PowerFilm-Solar/REF-IN-BLE-NS_4/Wiki Photos/Getting Started/Programming_Wiring_Diagram.png

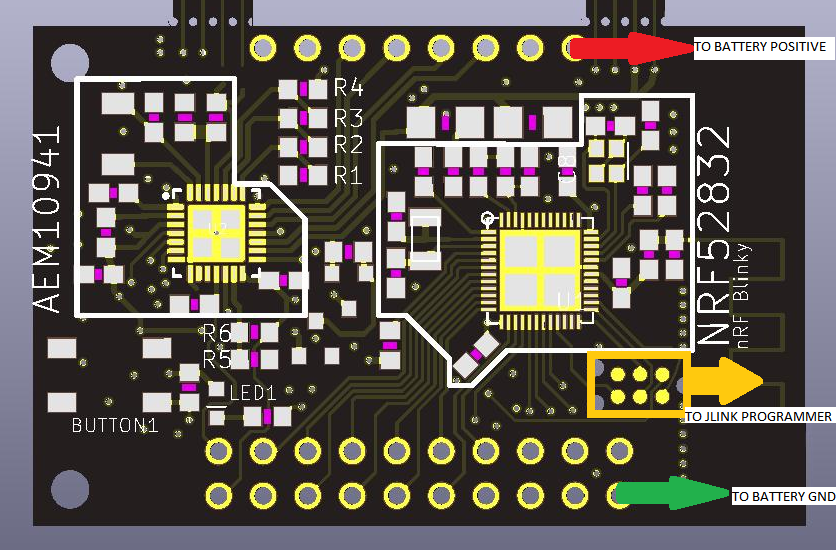
Wiki Photos/Getting Started/Programming_Wiring_Diagram.png
