PowerFilm-Solar/REF-IN-BLE-NS_4/Wiki Photos/Getting Started/Real_Programming_Wire_Diagram.jpg

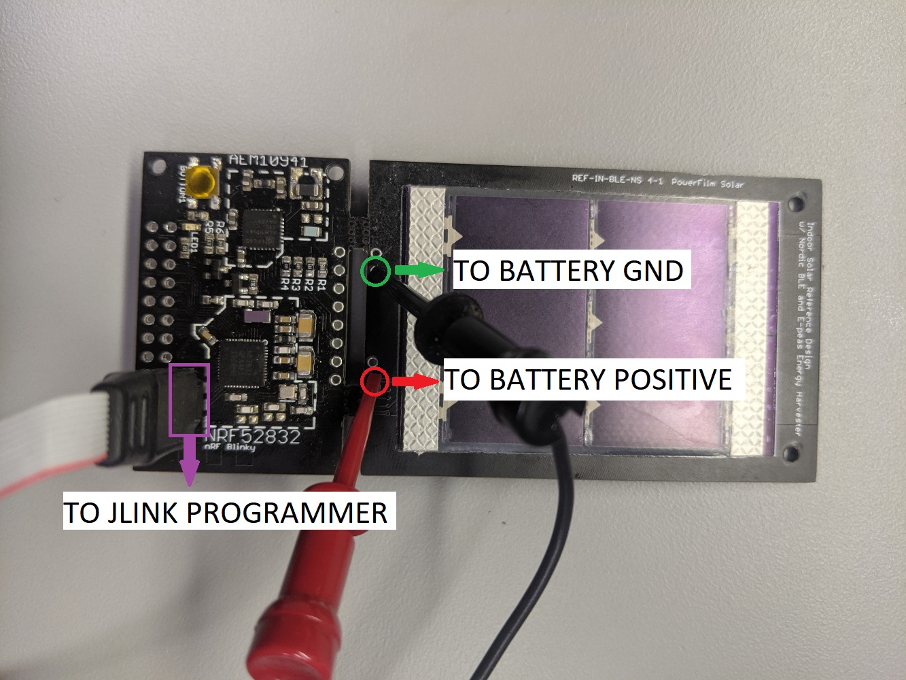
Wiki Photos/Getting Started/Real_Programming_Wire_Diagram.jpg
