PowerFilm-Solar/REF-IN-BLE-NS_4/README.md

# Thank you for your interest in PowerFilm's solar powered BLE reference Designs! Navigate to the Wiki tab to get started: https://github.com/PowerFilm-Solar/REF-IN-BLE-NS_4/wiki
