PowerFilm-Solar/REF-IN-BLE-NS_4/Boards/Mini/REF-BLE-MINI_Schematic.pdf

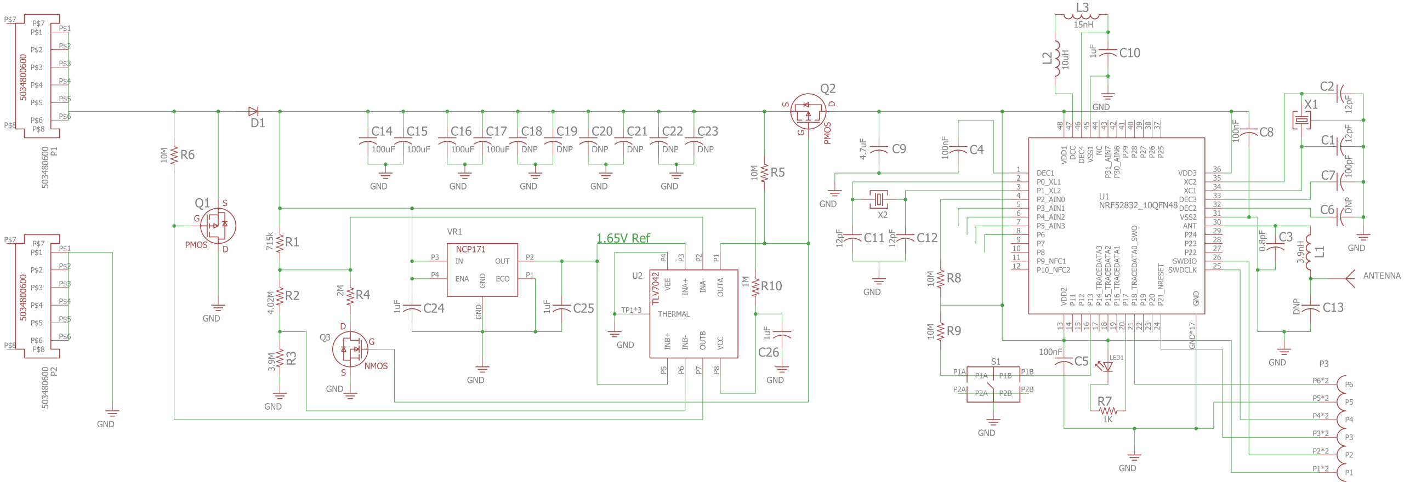
[picture p3: page 1]
