PowerFilm-Solar/REF-IN-BLE-NS_4/Boards/Flex/layout.pdf

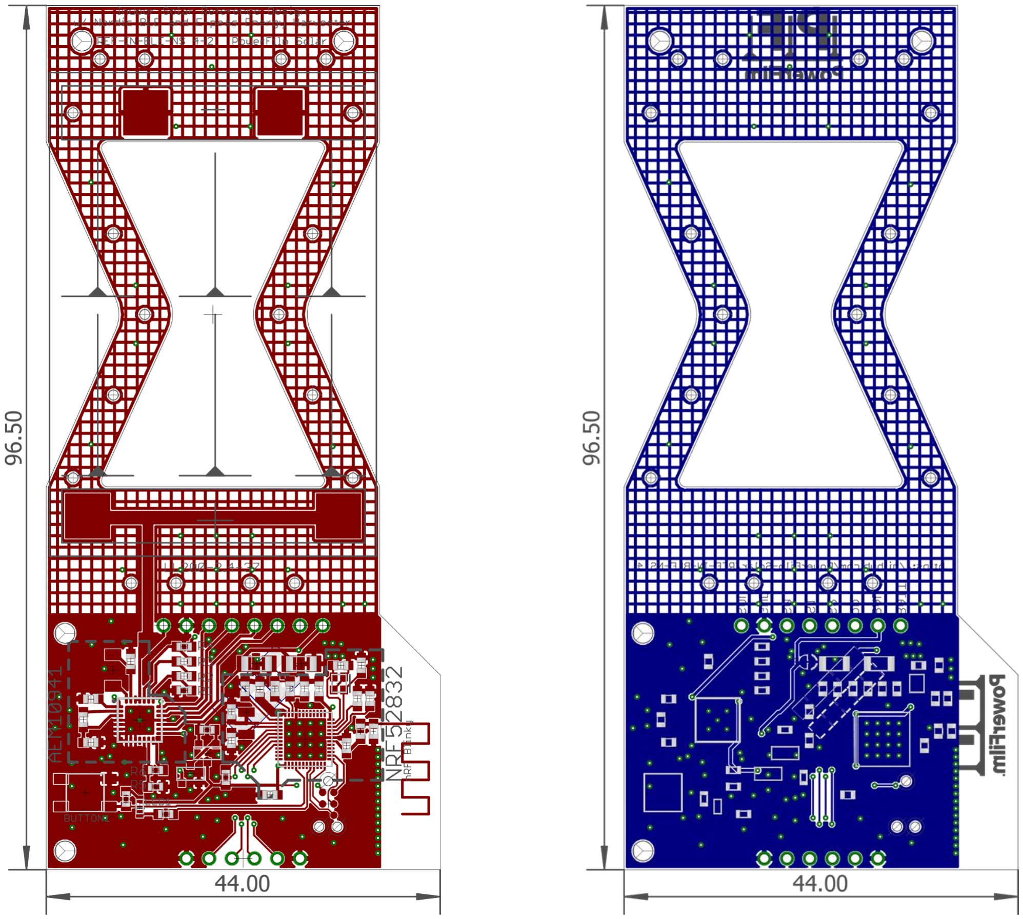
[picture p4: page 1]
