PowerFilm-Solar/REF-IN-BLE-NS_4/Boards/Rigid/layout.pdf

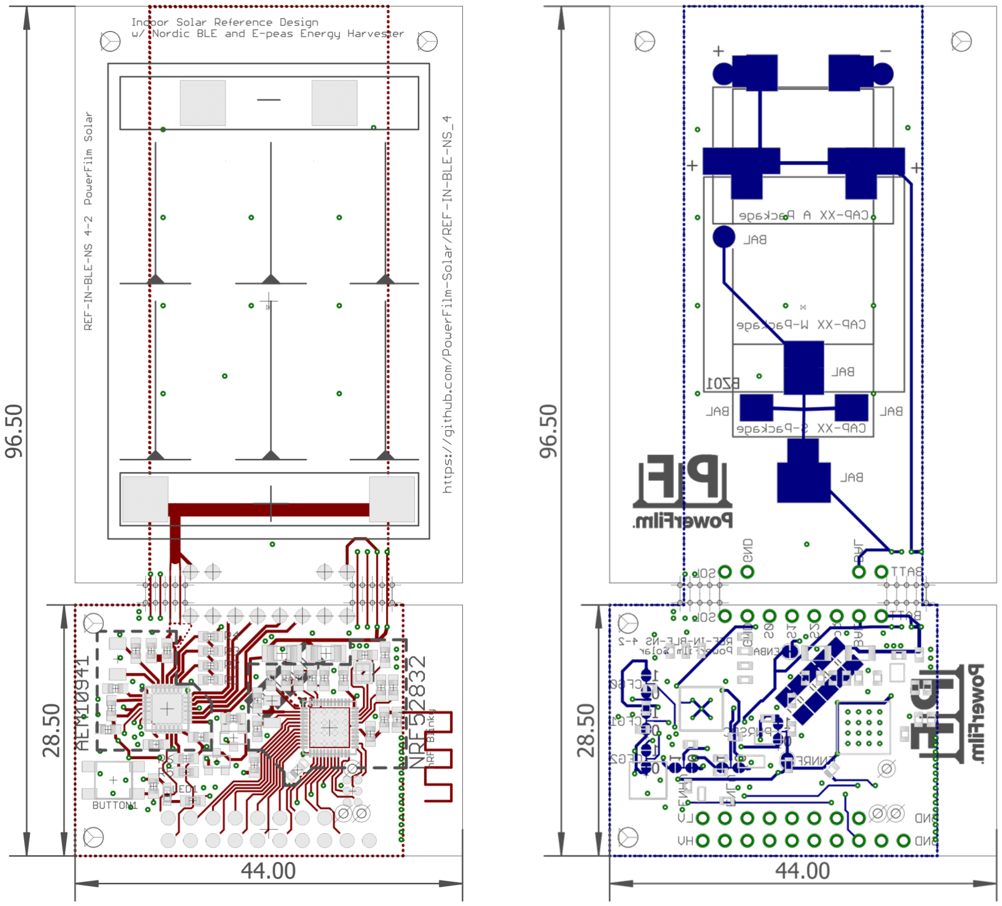
[picture p5: page 1]
