PowerFilm-Solar/REF-IN-BLE-NS_4/Wiki Photos/BLE_Reference_Designs.jpg

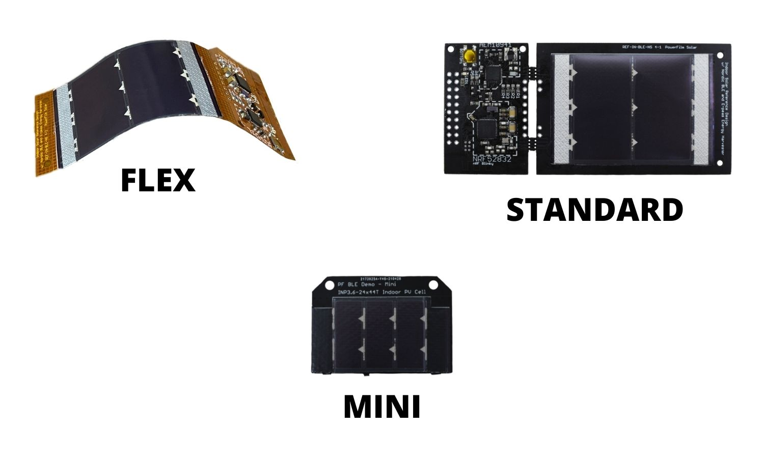
Wiki Photos/BLE_Reference_Designs.jpg
