PowerFilm-Solar/REF-IN-BLE-NS_4/Wiki Photos/Bootloader/Application Segger Loader.PNG

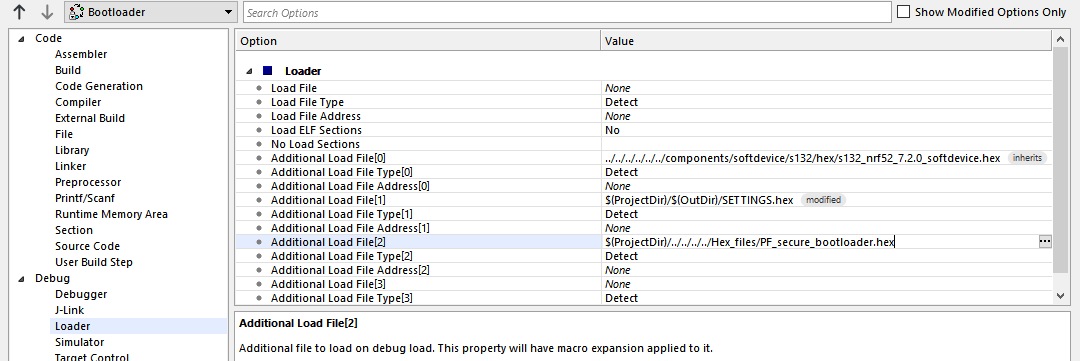
Wiki Photos/Bootloader/Application Segger Loader.PNG
