PowerFilm-Solar/REF-IN-BLE-NS_4/Wiki Photos/Bootloader/Bootloader Segger Post Link BL.PNG

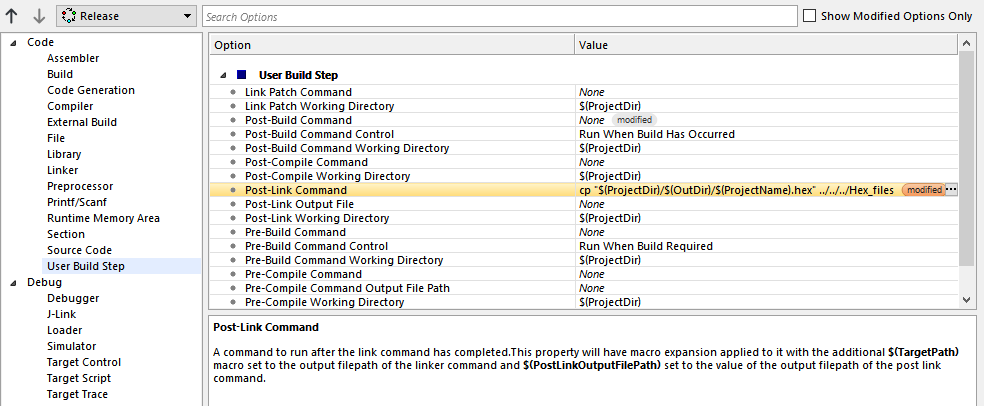
Wiki Photos/Bootloader/Bootloader Segger Post Link BL.PNG
