PowerFilm-Solar/REF-IN-BLE-NS_4/Wiki Photos/Bootloader/Files Needed.PNG

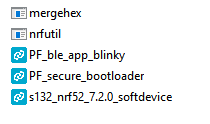
Wiki Photos/Bootloader/Files Needed.PNG
