PowerFilm-Solar/REF-IN-BLE-NS_4/Wiki Photos/Bootloader/Ready.png

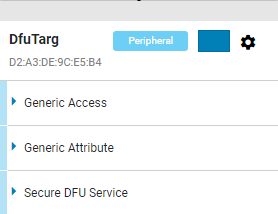
Wiki Photos/Bootloader/Ready.png
