PowerFilm-Solar/REF-IN-BLE-NS_4/Wiki Photos/Bootloader/Too early.png

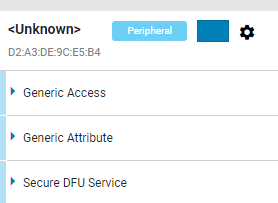
Wiki Photos/Bootloader/Too early.png
