PowerFilm-Solar/REF-IN-BLE-NS_4/Wiki Photos/Hardware Configuration/LDO_Bypass_Circuit_Block.PNG

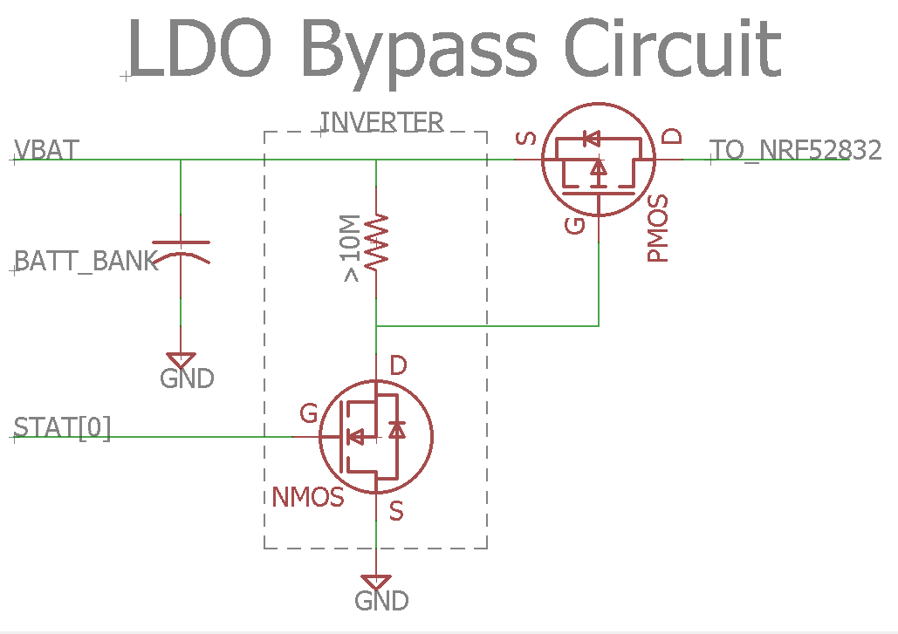
Wiki Photos/Hardware Configuration/LDO_Bypass_Circuit_Block.PNG
