PowerFilm-Solar/REF-IN-BLE-NS_4/Wiki Photos/Hardware Configuration/Recommended_Footprint.PNG

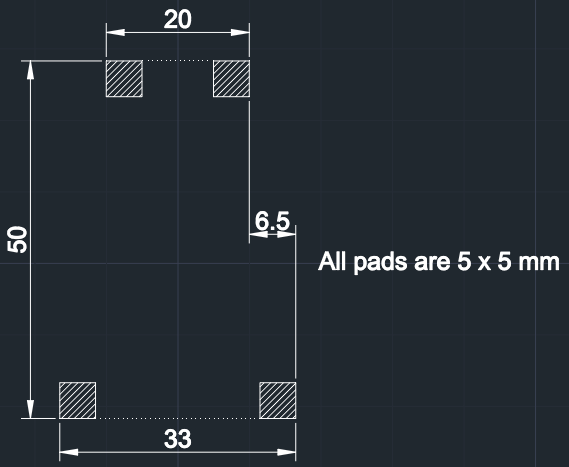
Wiki Photos/Hardware Configuration/Recommended_Footprint.PNG
