PowerFilm-Solar/REF-IN-BLE-NS_4/Wiki Photos/Power Saving Tips/PPK.PNG

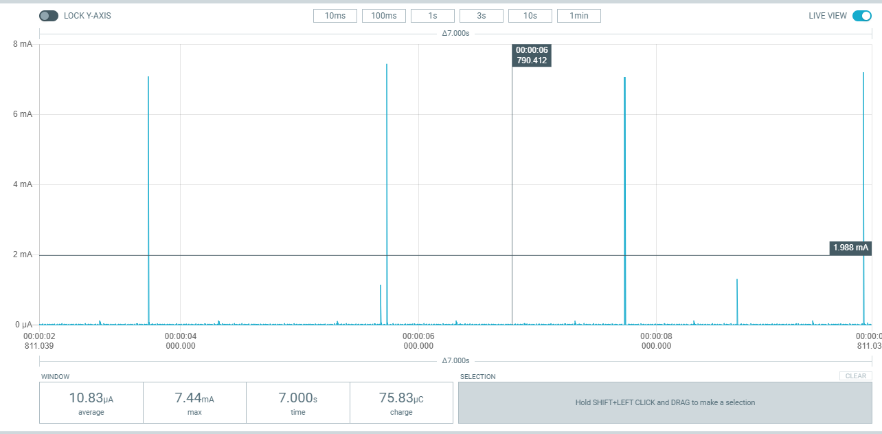
Wiki Photos/Power Saving Tips/PPK.PNG
