PowerFilm-Solar/REF-IN-BLE-NS_4/Boards/Mini/REF-BLE-MINI.xlsx

Sheet: Project BOM
Ref Des | Qty | Description | Size | Value | Percentage | Wattage | MFG Part #
R1 | 1 | Resistor | 0603 | 715k | 1% |  | RC0603FR-07715KL
R2 | 1 | Resistor | 0603 | 4.02M | 1% |  | RC0603FR-074M02L
R3 | 1 | Resistor | 0603 | 3.9M | 1% |  | CRCW06033M90FKEA‎
R4 | 1 | Resistor | 0603 | 2M | 1% |  | RC0603FR-072ML
R5,R6,R8,R9 | 4 | Resistor | 0603 | 10M | 1% |  | RC0603FR-0710ML
R7 | 1 | Resistor | 0603 | 1k | 1% |  | RMCF0603JJ1K00
R10 | 1 | Resistor | 0603 | 1M | 1% |  | RMCF0603FT1M00
C1,C2,C11,C12 | 4 | Capacitor | 0603 | 12pF | 2% | NP0 | GRM1885C1H120GA01D
C3 | 1 | Capacitor | 0603 | 0.8pF | 5% | NP0 | CBR06C808B5GAC
C4, C5, C8 | 3 | Capacitor | 0603 | 100nF | 10% | X5R | CL10B104KB8NNNC
C6 | 0 | Capacitor | 0603 | DNP
C7 | 1 | Capacitor | 0603 | 100pF | 5% | NP0 | CL10C101JB8NNNC
C9 | 1 | Capacitor | 0603 | 4.7uF | 5% | X5R | CL10A475KQ8NNWC
C10,C24,C25, C26 | 3 | Capacitor | 0603 | 1uF | 10% | X5R | CL10A105KP8NNNC
C13 | 0 | Capacitor | 0603 | DNP
C14,C15,C16,C17 | 4 | Capacitor | 1206 | 100uF |  |  | CL31A107MQHNNNE
C18,C19,C20,C21 ,C22,C23 | 0 | Capacitor | 1206 | DNP |  |  | DNP
L1 | 1 | Inductor | 0603 | 3.9nH | 5% |  | L-14C3N9SV4T
L2 | 1 | Inductor | 0603 | 10uH | 20% | 50mA | LBR2012T100M
L3 | 1 | Inductor | 0603 | 15nH | 10% |  | L-14C15NJV4T
D1 | 1 | Diode | SOD-523 | Schottky |  |  | BAT43WS-E3-08
LED1 | 1 | LED | 0603 |  |  |  | LTST-020KGKT
Q1,Q2 | 2 | Transistor | SOT-23 | P-Channel |  |  | BSS84,215
Q3 | 1 | Transistor | SOT-23 | N-Channel |  |  | NX138AKR
U1 | 1 | IC | 48-QFN |  |  |  | NRF52832-QFAA-R
U2 | 1 | IC | 8-WSON |  |  |  | TLV7042DSGR
VR1 | 1 | IC | 4-XDFN |  |  |  | NCP171AMX165160
X1 | 1 | Crystal | Nonstandard | 32MHz |  | 6pF | ECS-320-8-37B-CWY-TR
X2 | 1 | Crystal | Nonstandard | 32.768 kHz |  | 9pF | FC-135 32.7680KA-AC0
S1 | 1 | Switch | Nonstandard |  |  |  | EVQ-P7A01P
P1,P2 | 2 | Connector | Nonstandard |  |  |  | 5034800600

Sheet: Part Placement
Partlist
Exported | from REF-BLE-MINI.brd | at 9/1/2021 11:53 AM
EAGLE Ver | sion 7.7.0 Copyright ( | c) 1988-2016 CadSoft
Assembly | variant:
Part | Value | Package | Library | Position (mm) | Orientation
C1 | 12pF | C0603 | resistor | (28.41 23.49) | R0
C2 | 12pF | C0603 | resistor | (28.41 19.29) | R180
C3 | 0.8pF | C0603 | resistor | (34.8 20.8) | R180
C4 | 100nF | C0603 | resistor | (29.65 10.7) | R270
C5 | 100nF | C0603 | resistor | (40.29 13.01) | R0
C6 | DNP | C0603 | resistor | (32.6 23.2) | R90
C7 | 100pF | C0603 | resistor | (31.2 23.2) | R90
C8 | 100nF | C0603 | resistor | (28.4 17.9) | R180
C9 | 4.7uF | C0603 | resistor | (28.11 10.71) | R270
C10 | 1uF | C0603 | resistor | (26 19.2) | R90
C11 | 12pF | C0603 | resistor | (31.5 7.3) | R270
C12 | 12pF | C0603 | resistor | (34.3 7.3) | R270
C13 | DNP | C0603 | resistor | (37.3 23.7) | R0
C14 | 100uF | C1206 | resistor | (4 10.1) | R270
C15 | 100uF | C1206 | resistor | (6.3 10.1) | R270
C16 | 100uF | C1206 | resistor | (8.6 10.1) | R270
C17 | 100uF | C1206 | resistor | (10.9 10.1) | R270
C18 | DNP | C1206 | resistor | (13.2 10.1) | R270
C19 | DNP | C1206 | resistor | (15.5 10.1) | R270
C20 | DNP | C1206 | resistor | (17.8 10.1) | R270
C21 | DNP | C1206 | resistor | (20.1 10.1) | R270
C22 | DNP | C1206 | resistor | (22.4 10.1) | R270
C23 | DNP | C1206 | resistor | (24.7 10.1) | R270
C24 | 1uF | C0603 | resistor | (8.4 21.2) | R90
C25 | 1uF | C0603 | resistor | (5.1 18.6) | R180
C26 | 1uF | C0603 | resistor | (11 14.9) | R270
D1 | BAT43WS-E3-08 | SOD-323-VISHAY | 00_PF_Nordic | (6.9 13.7) | R180
L1 | 3.9nH | L0603 | 00_PF_Nordic | (35 23.4) | R270
L2 | 10uH | L0603 | 00_PF_Nordic | (28.4 14.6) | R0
L3 | 15nH | L0603 | 00_PF_Nordic | (28.4 15.9) | R180
LED1 | LTST-20KGKT | TST-20KGKT | 00_PF_Nordic | (34.1 1) | R180
P1 | 503480600 | 5034800600 | 00_PF_SMT | (5.4125 2) | R0
P2 | 503480600 | 5034800600 | 00_PF_SMT | (40.5875 2) | R0
Q1 | DMG2305U-13 | SOT-23-3-DIODESINC | 00_PF_Nordic | (4 16.2) | R180
Q2 | DMG2305U-13 | SOT-23-3-DIODESINC | 00_PF_Nordic | (16.1 15.7) | R270
Q3 | NX138AKR | SOT-23-3-RENESAS | 00_PF_Nordic | (15.5 21.4) | R90
R1 | 715k | R0603 | resistor | (10 21.2) | R270
R2 | 4.02M | R0603 | resistor | (11.4 21.2) | R90
R3 | 3.9M | R0603 | resistor | (12.8 21.2) | R270
R4 | 2M | R0603 | resistor | (14.2 18.4) | R0
R5 | 10M | R0603 | resistor | (13.5 15.7) | R90
R6 | 10M | R0603 | resistor | (6.5 16.4) | R90
R7 | 1K | R0603 | resistor | (36.96 3.82) | R90
R8 | 10M | R0603 | resistor | (36 7.3) | R270
R9 | 10M | R0603 | resistor | (31.85 4.25) | R180
R10 | 1M | R0603 | resistor | (9.5 14.9) | R90
S1 | EVQ-P7A01P | EVQ-P7A01P | 00_PF_Nordic | (28 1.4) | R0
U1 | NRF52832_10QFN48 | NRF52832_10 | 00_PF_Nordic | (34.5 16) | R90
U2 | TLV7042DSG | TLV7042DSG | 00_PF_Nordic | (10.4 17.8) | R180
VR1 | NCP171 | NCP171 | 00_PF_Nordic | (5.7 20.8) | R0
X1 | FA-128-32MHZMF10Z-AJ5 | FA-128-EPSON | 00_PF_Nordic | (28.51 21.39) | R90
X2 | FC-135-32.7680KA-AC0 | FC-135-32.7680KA-AC0 | 00_PF_Nordic | (32.9 9.9) | R180
