PowerFilm-Solar/REF-IN-BLE-NS_4/Wiki Photos/Bootloader/Application Segger Post Build.PNG

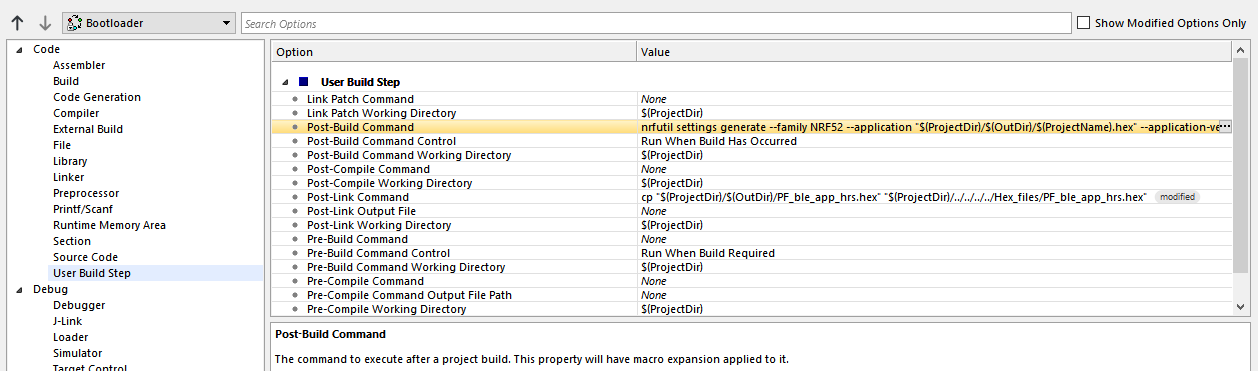
Wiki Photos/Bootloader/Application Segger Post Build.PNG
