PowerFilm-Solar/REF-IN-BLE-NS_4/Wiki Photos/Getting Started/Build_And_Run.PNG

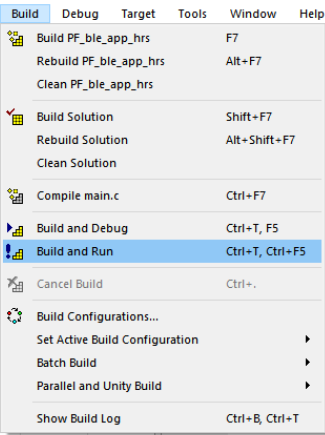
Wiki Photos/Getting Started/Build_And_Run.PNG
