PowerFilm-Solar/REF-IN-BLE-NS_4/Wiki Photos/Getting Started/Connection_To_HRM_Desktop_App.PNG

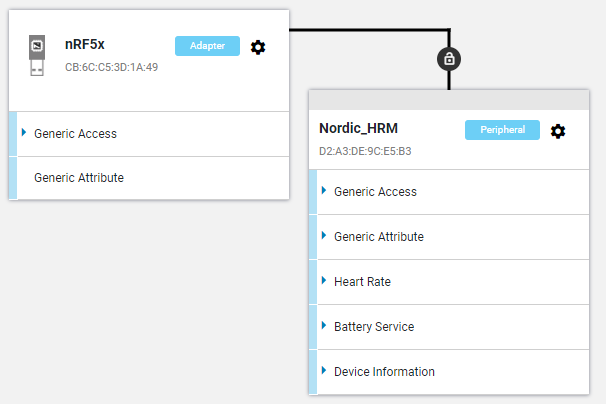
Wiki Photos/Getting Started/Connection_To_HRM_Desktop_App.PNG
