PowerFilm-Solar/REF-IN-BLE-NS_4/Wiki Photos/Getting Started/Ensure_These_Are_Selected.PNG

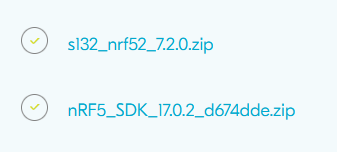
Wiki Photos/Getting Started/Ensure_These_Are_Selected.PNG
