PowerFilm-Solar/REF-IN-BLE-NS_4/Wiki Photos/Getting Started/Hex_Files_Folder.PNG

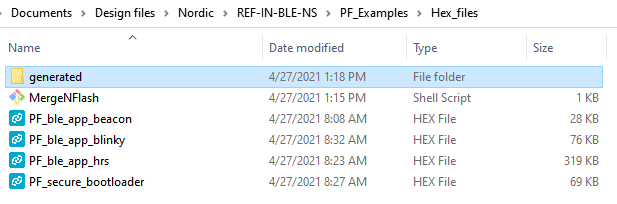
Wiki Photos/Getting Started/Hex_Files_Folder.PNG
