PowerFilm-Solar/REF-IN-BLE-NS_4/Wiki Photos/Getting Started/JLink_As_drive.PNG

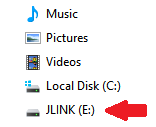
Wiki Photos/Getting Started/JLink_As_drive.PNG
