PowerFilm-Solar/REF-IN-BLE-NS_4/Wiki Photos/Getting Started/Preferred_Conn_Params.png

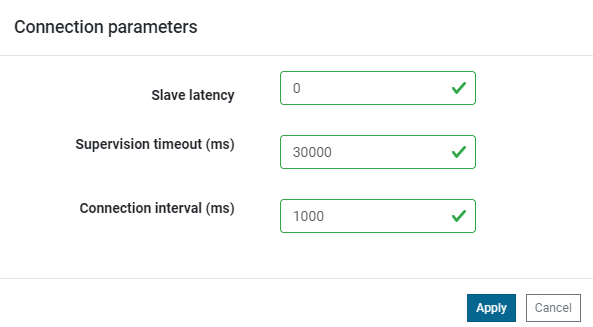
Wiki Photos/Getting Started/Preferred_Conn_Params.png
