PowerFilm-Solar/REF-IN-BLE-NS_4/Wiki Photos/Getting Started/SD_S132_Selected.PNG

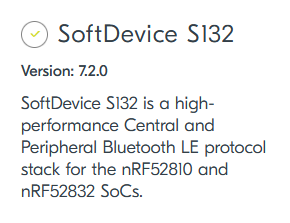
Wiki Photos/Getting Started/SD_S132_Selected.PNG
