PowerFilm-Solar/REF-IN-BLE-NS_4/Wiki Photos/Getting Started/SDK_17-0-2.PNG

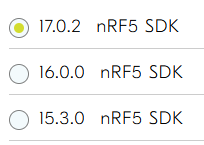
Wiki Photos/Getting Started/SDK_17-0-2.PNG
