PowerFilm-Solar/REF-IN-BLE-NS_4/Wiki Photos/Getting Started/Select_Conn_Params.png

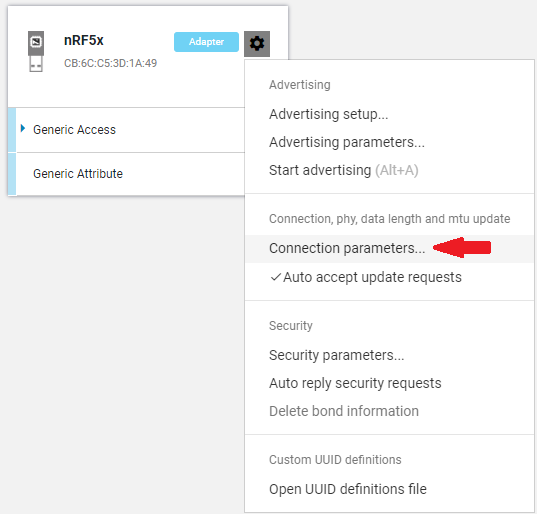
Wiki Photos/Getting Started/Select_Conn_Params.png
