PowerFilm-Solar/REF-IN-BLE-NS_4/(threads)

Thread 1 (2021-01-13):

REF-IN-BLE-NS 4-1 sam notes

samjonesPF, 2021-01-13:
- change solder bridge fonts to vector style -- make sure it doesn't effect alignment
- ENBAL needs to be mirrored
- change references to say revision 4-1
- change to 4 layer board with two internal ground planes. Go through and make sure any part that goes to ground has a ground via next to it.
- break negative panel contact up into two pads so all contacts are the same size
- add part labels to the button and switch
- add reference to "nRF Blinky" somewhere on the board since that is what we will load by default

Closed 2021-01-13.
