PowerFilm-Solar/REF-IN-BLE-NS_4/Boards/Rigid/schematic.pdf

CAP-XX Super-capacitors AVX Super-capacitors | 1206 Footprints

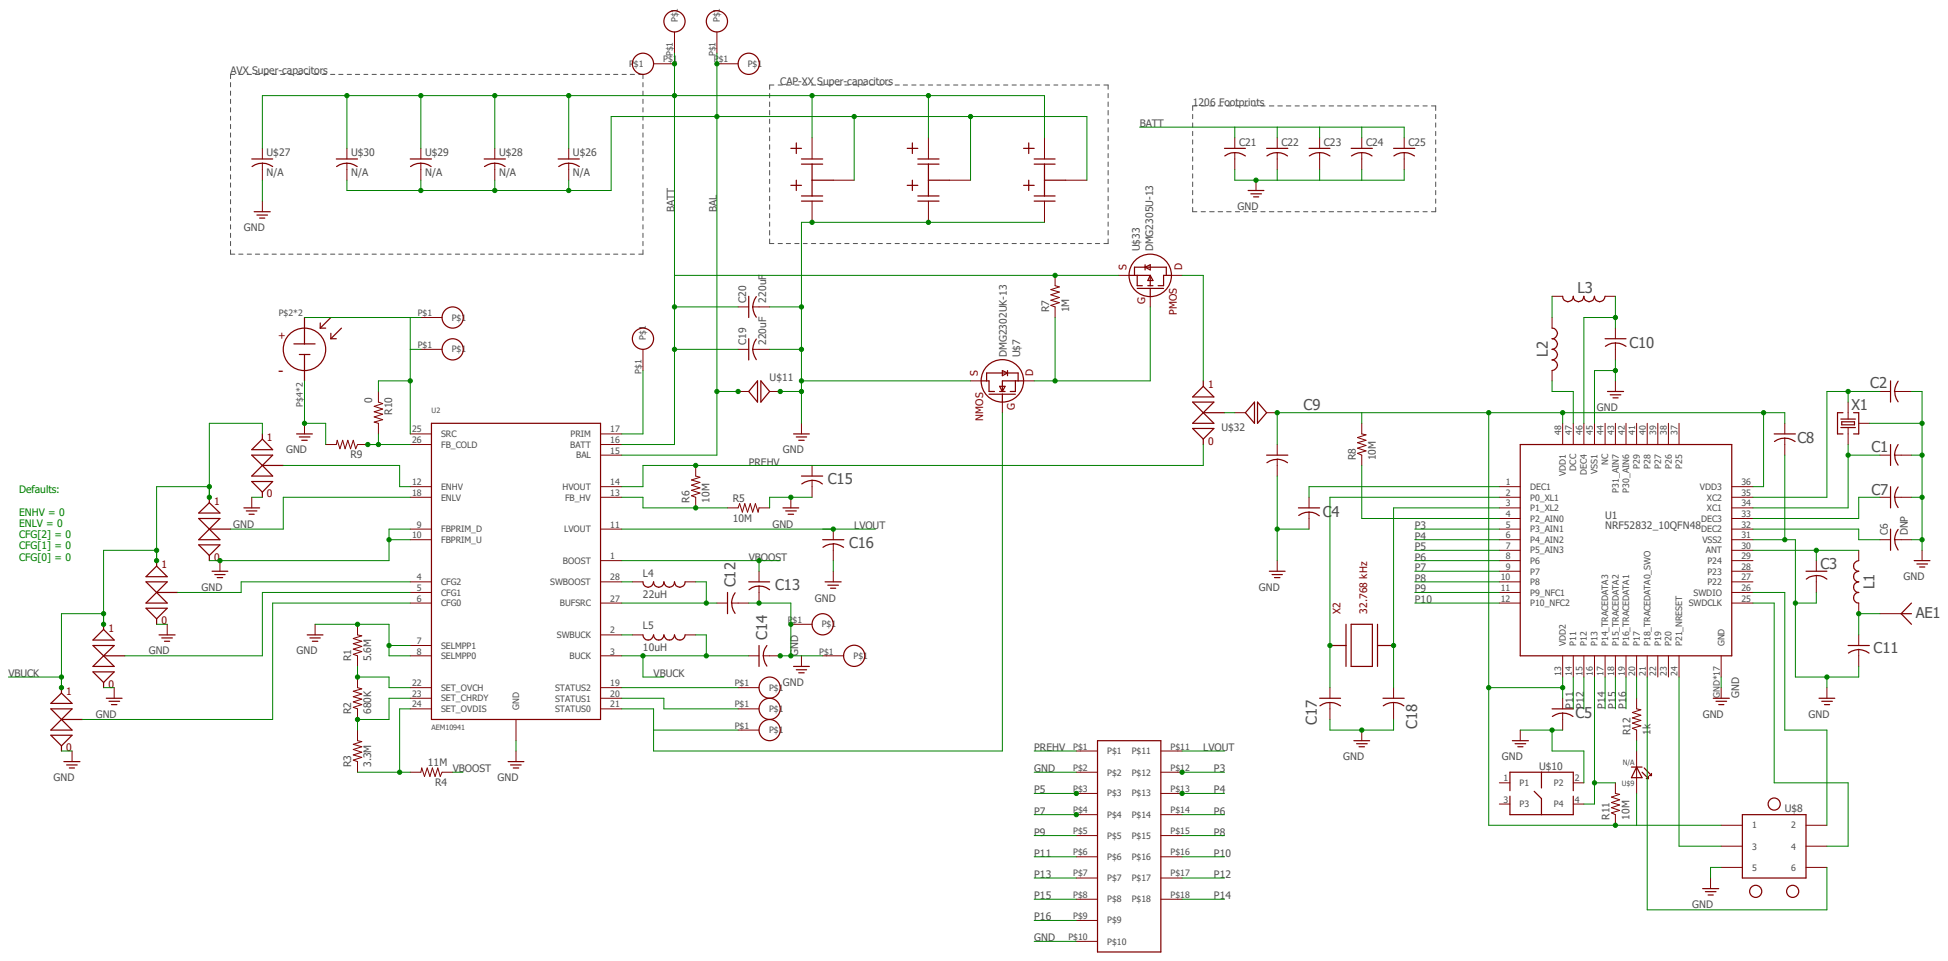
[picture p25: page 1]
