PowerFilm-Solar/REF-IN-BLE-NS_4/Boards/Flex/schematic.pdf

L3 L2 | L1

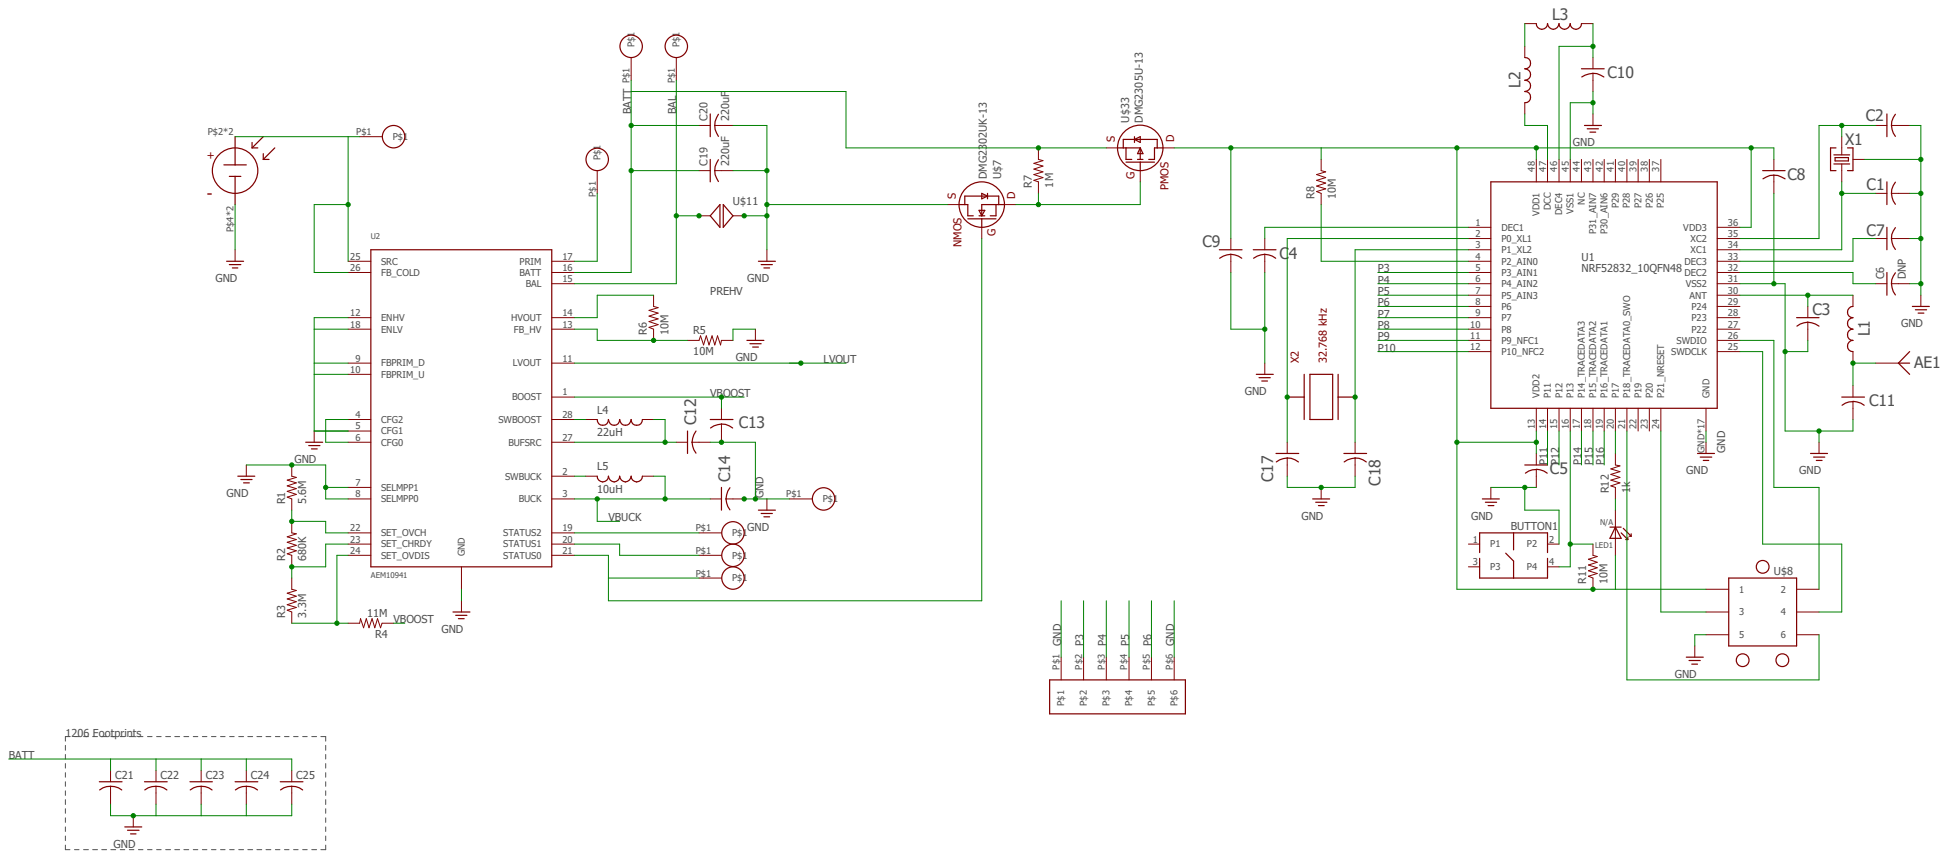
[picture p26: page 1]
