PowerFilm-Solar/REF-IN-BLE-NS_4/Boards/Mini/REF-BLE-MINI.brd

## EAGLE design Boards/Mini/REF-BLE-MINI.brd (2021-09-02)

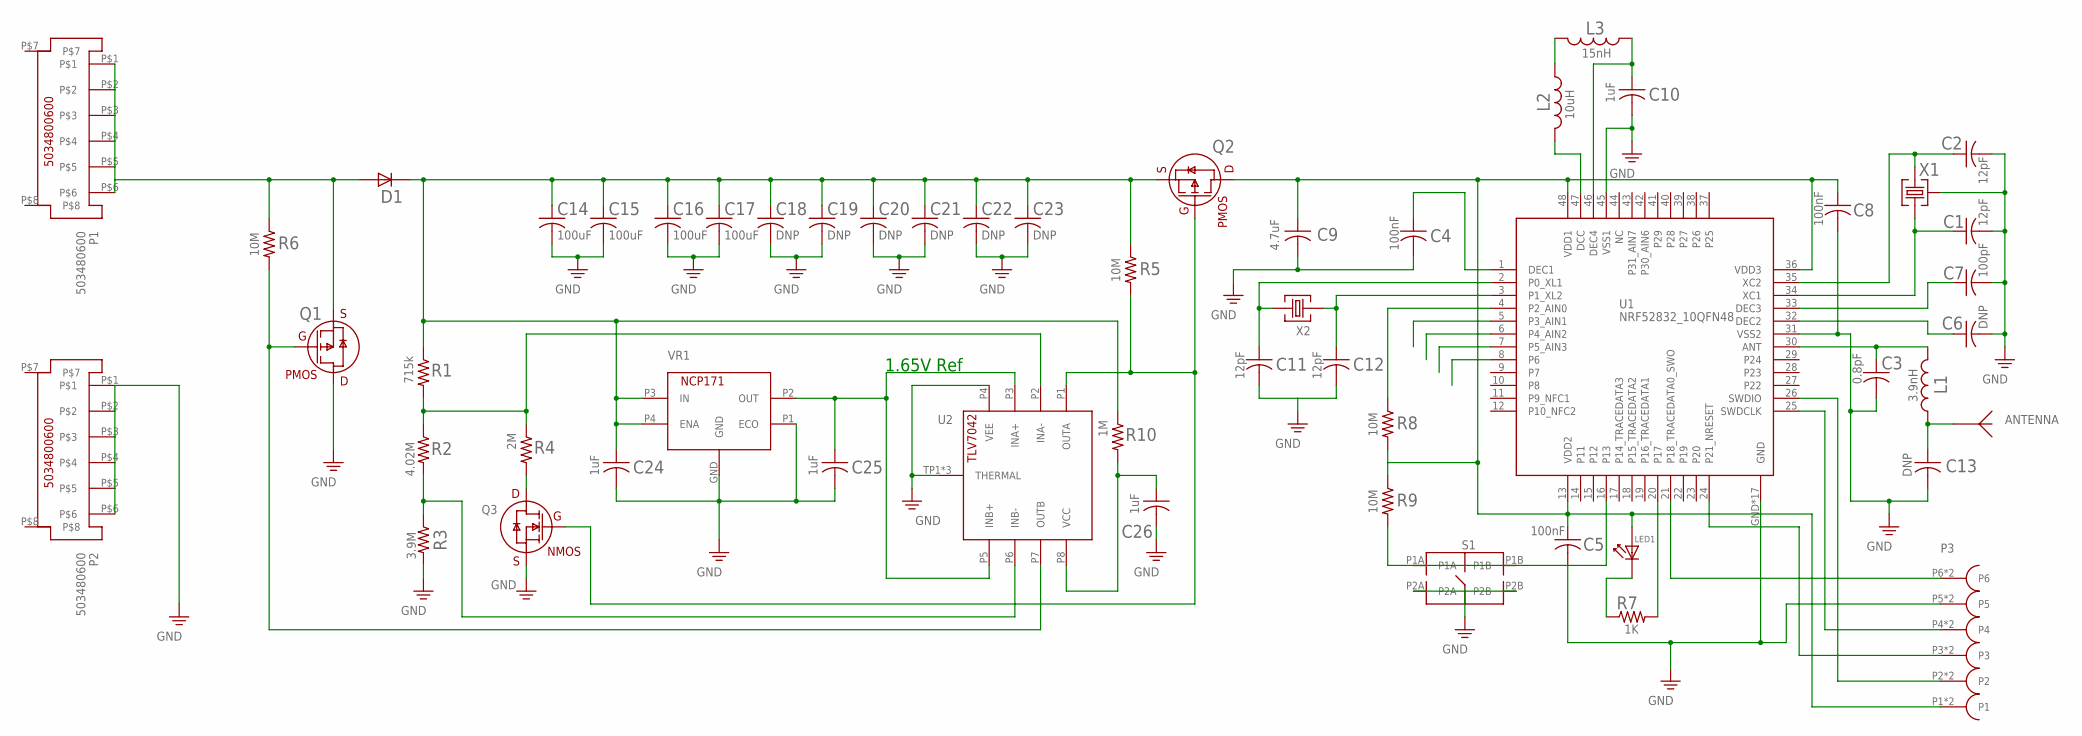
[picture p27: schematic REF-BLE-MINI.sch, sheet 1]

Parts:
ANTENNA: BLE-ANTENNA-NORDIC-2
C1, C2, C11, C12: 12pF; C0603
C3: 0.8pF; C0603
C4, C5, C8: 100nF; C0603
C6, C13: DNP; C0603
C7: 100pF; C0603
C9: 4.7uF; C0603
C10, C24, C25, C26: 1uF; C0603
C14, C15, C16, C17: 100uF; C1206
C18, C19, C20, C21, C22, C23: DNP; C1206
D1: BAT43WS-E3-08; SOD-323-VISHAY
L1: 3.9nH; L0603
L2: 10uH; L0603
L3: 15nH; L0603
LED1: LTST-20KGKT; TST-20KGKT
P1, P2: 503480600; 5034800600
P3: EC-06-CTX
Q1, Q2: DMG2305U-13; SOT-23-3-DIODESINC
Q3: NX138AKR; SOT-23-3-RENESAS
R1: 715k; R0603
R2: 4.02M; R0603
R3: 3.9M; R0603
R4: 2M; R0603
R5, R6, R8, R9: 10M; R0603
R7: 1K; R0603
R10: 1M; R0603
S1: EVQ-P7A01P
U1: NRF52832_10QFN48; NRF52832_10
U2: TLV7042DSG
VR1: NCP171
X1: FA-128-32MHZMF10Z-AJ5; FA-128-EPSON
X2: FC-135-32.7680KA-AC0

Connections:
GND: C1.2, C2.2, C3.2, C4.2, C5.2, C6.2, C7.2, C8.2, C9.2, C10.2, C11.2, C12.2, C13.2, C14.2, C15.2, C16.2, C17.2, C18.2, C19.2, C20.2, C21.2, C22.2, C23.2, C24.2, C25.2, P2.P$1, P2.P$2, P2.P$3, P2.P$4, P2.P$5, P2.P$6, P3.P5, P3.P11 (P5), Q1.3 (D), Q3.2 (S), R3.2, S1.P2A, S1.P2B, U1.31 (VSS2), U1.45 (VSS1), U1.GND, U1.P$2 (GND), U1.P$3 (GND), U1.P$4 (GND), U1.P$5 (GND), U1.P$6 (GND), U1.P$7 (GND), U1.P$8 (GND), U1.P$9 (GND), U1.P$10 (GND), U1.P$11 (GND), U1.P$12 (GND), U1.P$13 (GND), U1.P$14 (GND), U1.P$15 (GND), U1.P$16 (GND), U1.P$17 (GND), U2.P4 (VEE), U2.TP1 (THERMAL), U2.TP2 (THERMAL), U2.TP3 (THERMAL), VR1.GND, VR1.P1 (ECO), X1.P2 (P3), X1.P4 (P3)
unnamed: L2.2, U1.47 (DCC)
unnamed: L2.1, L3.2
unnamed: C10.1, L3.1, U1.46 (DEC4)
unnamed: C12.1, U1.3 (P1_XL2), X2.P$1 (1)
unnamed: C4.1, U1.1 (DEC1)
unnamed: C2.1, U1.35 (XC2), X1.P1 (2)
unnamed: C1.1, U1.34 (XC1), X1.P3 (1)
unnamed: C3.1, L1.2, U1.30 (ANT)
unnamed: ANTENNA.P$1, ANTENNA.P$2, C13.1, L1.1
unnamed: C7.1, U1.33 (DEC3)
unnamed: C6.1, U1.32 (DEC2)
unnamed: D1.P2, P1.P$1, P1.P$2, P1.P$3, P1.P$4, P1.P$5, P1.P$6, Q1.2 (S), R6.1
unnamed: C11.1, U1.2 (P0_XL1), X2.P$2 (2)
unnamed: C14.1, C15.1, C16.1, C17.1, C18.1, C19.1, C20.1, C21.1, C22.1, C23.1, C24.1, D1.P1, Q2.2 (S), R1.1, R5.1, R10.1, VR1.P3 (IN), VR1.P4 (ENA)
unnamed: R1.2, R2.1, R4.1, U2.P2 (INA-)
unnamed: Q2.1 (G), Q3.1 (G), R5.2, U2.P1 (OUTA)
unnamed: LED1.C, R7.1
unnamed: R2.2, R3.1, U2.P6 (INB-)
unnamed: R7.2, U1.20 (P17)
unnamed: C25.1, U2.P3 (INA+), U2.P5 (INB+), VR1.P2 (OUT)
unnamed: P3.P4, P3.P10 (P4), U1.25 (SWDCLK)
unnamed: P3.P3, P3.P9 (P3), U1.24 (P21_NRESET)
unnamed: Q1.1 (G), R6.2, U2.P7 (OUTB)
unnamed: R9.2, S1.P1A, S1.P1B, U1.16 (P13)
unnamed: P3.P6, P3.P12 (P6), U1.21 (P18_TRACEDATA0_SWO)
unnamed: P3.P2, P3.P8 (P2), U1.26 (SWDIO)
unnamed: R8.1, U1.4 (P2_AIN0)
unnamed: C5.1, C8.1, C9.1, LED1.A, P3.P1, P3.P7 (P1), Q2.3 (D), R8.2, R9.1, U1.13 (VDD2), U1.36 (VDD3), U1.48 (VDD1)
unnamed: Q3.3 (D), R4.2
unnamed: C26.1, R10.2, U2.P8 (VCC)
PE: C26.2

Notes on the sheet:
1.65V Ref

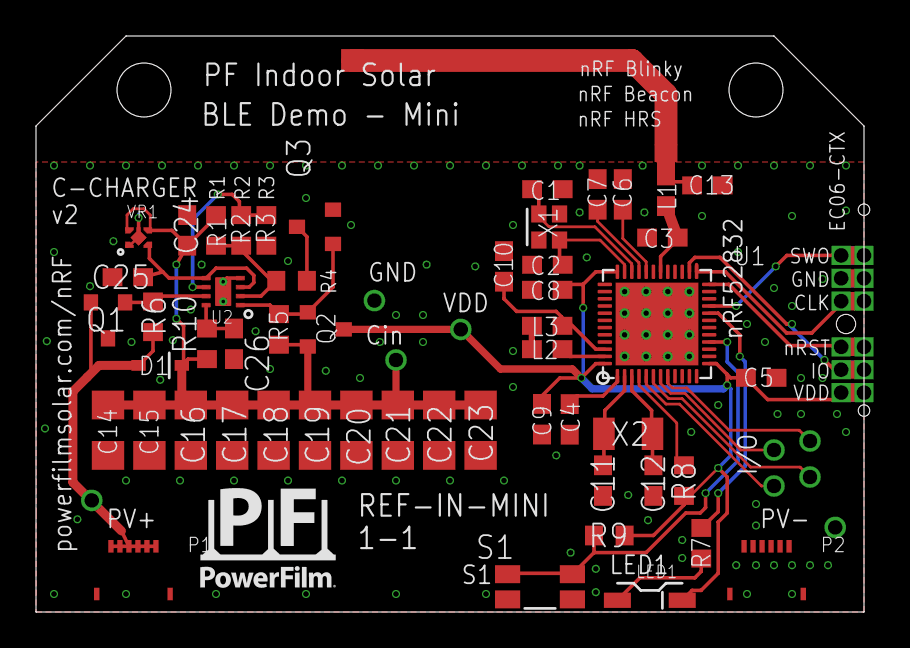
[picture p28: board REF-BLE-MINI.brd from above]

Board: 2 copper layers, 46.0 x 32.0 mm, 54 parts (0 on the bottom side), 31 nets.
