PowerFilm-Solar/REF-IN-BLE-NS_4/Boards/Rigid/REF-IN-BLE-NS 4-2 Rigid.brd

## EAGLE design Boards/Rigid/REF-IN-BLE-NS 4-2 Rigid.brd (2021-08-06)

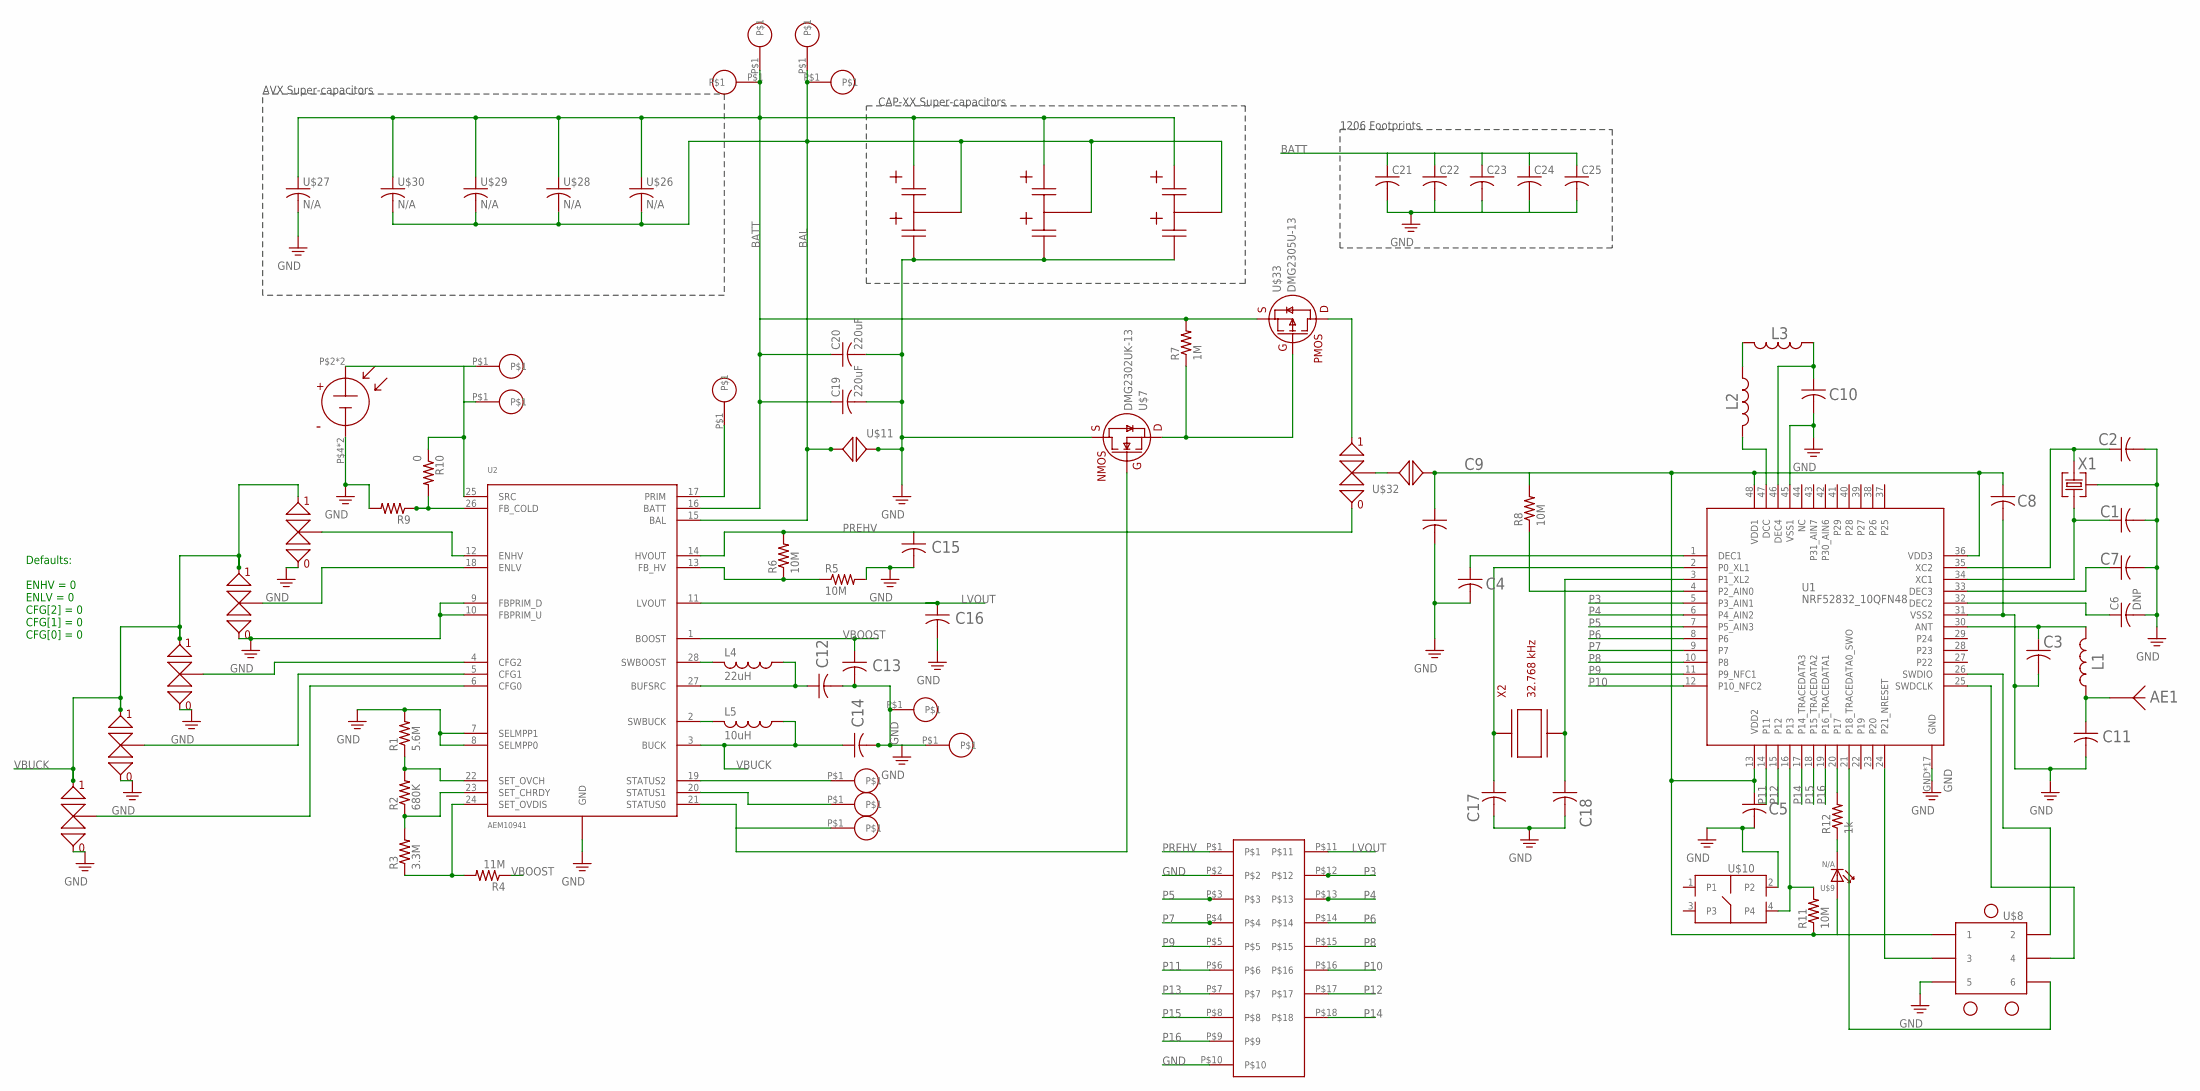
[picture p29: schematic REF-IN-BLE-NS 4-2 Rigid.sch]

Parts:
AE1: 2.4GHZ_ANTENNAFLIPPED; BLE_ANTENNA_NORDIC_FLIPPED
C1, C2: 12pF; C0603
C3: 0.8pF; C0603
C4, C5, C8: 100nF; C0603
C6, C11: DNP; C0603
C7: 100pF; C0603
C9: 4.7uF; C0603
C10: 1uF; C0603
C12, C14, C15, C16: 10uF; C0603
C13: 22uF; C0603
C17, C18: 12p; C0603
C19, C20: 220uF; C1206
C21, C22, C23, C24, C25: C-USC1206; C1206
L1: 3.9nH; L0603
L2, L5: 10uH; L0603
L3: 15nH; L0603
L4: 22uH; L1206
R1: 5.6M; R0603
R2: 680K; R0603
R3: 3.3M; R0603
R4: 11M; R0603
R5, R6, R8, R11: 10M; R0603
R7: 1M; R0603
R9: R-US_R0603; R0603
R10: 0; R0603
R12: 1k; R0603
U1: NRF52832_10QFN48; NRF52832_10
U2: AEM10941; QFN28_5X5_05PITCH
U$2, U$3, U$4, U$5, U$6: N/A; DOUBLE_SOLDER_BRIDGE_0_CLOSED
U$7: DMG2302UK-13; SOT-23-3-DIODESINC
U$8: N/A; TC2030-IDC
U$9: N/A; APT1608LZGCK
U$10: MJTP1140; MJTP1140A
U$11, U$32: SOLDER_BRIGDECLOSED; SOLDER_BRIDGE_CLOSED
U$12, U$13, U$14, U$15, U$17, U$18, U$19, U$35, U$36, U$39, U$40, U$41: N/A; 1MM_PAD
U$16: SOLAR_CELL_LL200-2.4-37; SOLAR_CELL_37X54MM
U$20: 18PIN_CONN; 20PIN_CONN
U$23: N/A; CAP-XX_A-TYPE
U$24: N/A; CAP-XX_S-TYPE
U$25: N/A; CAP-XX_W-TYPE
U$26: N/A; BZ01_L-TYPE
U$27: N/A; BZ059_N-TYPE
U$28: N/A; BZ01_S-TYPE
U$29: N/A; BZ05_S-TYPE
U$30: N/A; BZ09_S-TYPE
U$31: DOUBLE_SOLDER_BRIDGE1_CLOSED; DOUBLE_SOLDER_BRIDGE_1_CLOSED
U$33: DMG2305U-13; SOT-23-3-DIODESINC
X1: 32 MHz; FA-128-EPSON
X2: 32.768 kHz; FC-135

Connections:
BAL: U2.15 (BAL), U$11.P$1 (P1), U$19.P$1, U$23.P$1 (BAL), U$24.P$1 (BAL), U$25.P$1 (BAL), U$26.P$3 (2), U$26.P$4 (2), U$28.P$3 (2), U$29.P$3 (2), U$30.P$3 (2), U$41.P$1
BATT: C19.1, C20.1, C21.1, C22.1, C23.1, C24.1, C25.1, R7.2, U2.16 (BATT), U$18.P$1, U$23.P$2 (+), U$24.P$2 (+), U$25.P$2 (+), U$26.P$1 (1), U$26.P$2 (1), U$27.P$1 (1), U$28.P$1 (1), U$28.P$2 (1), U$29.P$1 (1), U$29.P$2 (1), U$30.P$1 (1), U$30.P$2 (1), U$33.2 (S), U$40.P$1
GND: C1.2, C2.2, C3.2, C4.2, C5.2, C6.2, C7.2, C8.2, C9.2, C10.2, C11.2, C12.2, C13.2, C14.2, C15.2, C16.2, C17.2, C18.2, C19.2, C20.2, C21.2, C22.2, C23.2, C24.2, C25.2, R1.2, R5.2, R9.2, U1.31 (VSS2), U1.45 (VSS1), U1.GND, U1.P$2 (GND), U1.P$3 (GND), U1.P$4 (GND), U1.P$5 (GND), U1.P$6 (GND), U1.P$7 (GND), U1.P$8 (GND), U1.P$9 (GND), U1.P$10 (GND), U1.P$11 (GND), U1.P$12 (GND), U1.P$13 (GND), U1.P$14 (GND), U1.P$15 (GND), U1.P$16 (GND), U1.P$17 (GND), U2.7 (SELMPP1), U2.8 (SELMPP0), U2.9 (FBPRIM_D), U2.10 (FBPRIM_U), U2.GND, U2.GND1 (GND), U2.GND2 (GND), U2.GND3 (GND), U2.GND4 (GND), U2.GND5 (GND), U$2.IN0, U$3.IN0, U$4.IN0, U$5.IN0, U$6.IN0, U$7.2 (S), U$8.P5 (5), U$10.2, U$11.P$2 (P2), U$16.P$4 (GND), U$16.P$5 (GND), U$17.P$1, U$20.P$2, U$20.P$10, U$23.P$3 (-), U$24.P$3 (-), U$25.P$3 (-), U$27.P$2 (2), U$35.P$1, X1.P2 (P3), X1.P4 (P3)
HVOUT: C5.1, C8.1, C9.1, R8.2, R11.1, U1.13 (VDD2), U1.36 (VDD3), U1.48 (VDD1), U$8.P1 (1), U$9.A, U$32.P$1 (P1)
LVOUT: C16.1, U2.11 (LVOUT), U$20.P$11
unnamed: L2.2, U1.47 (DCC)
unnamed: L2.1, L3.2
unnamed: C10.1, L3.1, U1.46 (DEC4)
unnamed: C4.1, U1.1 (DEC1)
unnamed: C2.1, U1.35 (XC2), X1.P1 (2)
unnamed: C1.1, U1.34 (XC1), X1.P3 (1)
unnamed: C3.1, L1.2, U1.30 (ANT)
unnamed: AE1.P$1, C11.1, L1.1
unnamed: C7.1, U1.33 (DEC3)
unnamed: C6.1, U1.32 (DEC2)
unnamed: L4.P$2 (2), U2.28 (SWBOOST)
unnamed: C12.1, L4.P$1 (1), U2.27 (BUFSRC)
unnamed: R1.1, R2.2, U2.22 (SET_OVCH)
unnamed: L5.2, U2.2 (SWBUCK)
unnamed: R2.1, R3.2, U2.23 (SET_CHRDY)
unnamed: R11.2, U1.16 (P13), U$10.4
unnamed: R3.1, R4.2, U2.24 (SET_OVDIS)
unnamed: U2.4 (CFG2), U$4.OUT
unnamed: U2.18 (ENLV), U$3.OUT
unnamed: U1.25 (SWDCLK), U$8.P4 (4)
unnamed: U1.24 (P21_NRESET), U$8.P3 (3)
unnamed: U2.12 (ENHV), U$2.OUT
unnamed: U1.26 (SWDIO), U$8.P2 (2)
unnamed: U1.21 (P18_TRACEDATA0_SWO), U$8.P6 (6)
unnamed: U2.5 (CFG1), U$5.OUT
unnamed: U2.6 (CFG0), U$6.OUT
unnamed: R5.1, R6.1, U2.13 (FB_HV)
unnamed: R10.1, U2.25 (SRC), U$16.P$2 (VOUT), U$16.P$3 (VOUT), U$36.P$1, U$39.P$1
unnamed: R12.1, U$9.C
unnamed: R12.2, U1.20 (P17)
unnamed: R9.1, R10.2, U2.26 (FB_COLD)
unnamed: C17.1, U1.2 (P0_XL1), X2.P$1
unnamed: C18.1, U1.3 (P1_XL2), X2.P$2
unnamed: R8.1, U1.4 (P2_AIN0)
unnamed: U$31.OUT, U$32.P$2 (P2)
unnamed: U$31.IN1, U$33.3 (D)
unnamed: R7.1, U$7.3 (D), U$33.1 (G)
P3: U1.5 (P3_AIN1), U$20.P$12
P4: U1.6 (P4_AIN2), U$20.P$13
P5: U1.7 (P5_AIN3), U$20.P$3
P6: U1.8 (P6), U$20.P$14
P7: U1.9 (P7), U$20.P$4
P8: U1.10 (P8), U$20.P$15
P9: U1.11 (P9_NFC1), U$20.P$5
P10: U1.12 (P10_NFC2), U$20.P$16
P11: U1.14 (P11), U$20.P$6
P12: U1.15 (P12), U$20.P$17
P13: U$20.P$7
P14: U1.17 (P14_TRACEDATA3), U$20.P$18
P15: U1.18 (P15_TRACEDATA2), U$20.P$8
P16: U1.19 (P16_TRACEDATA1), U$20.P$9
PREHV: C15.1, R6.2, U2.14 (HVOUT), U$20.P$1, U$31.IN0
PRIM: U2.17 (PRIM), U$12.P$1
STATUS0: U2.21 (STATUS0), U$7.1 (G), U$15.P$1
STATUS1: U2.20 (STATUS1), U$14.P$1
STATUS2: U2.19 (STATUS2), U$13.P$1
VBOOST: C13.1, R4.1, U2.1 (BOOST)
VBUCK: C14.1, L5.1, U2.3 (BUCK), U$2.IN1, U$3.IN1, U$4.IN1, U$5.IN1, U$6.IN1

Notes on the sheet:
Defaults: ENHV = 0 ENLV = 0 CFG[2] = 0 CFG[1] = 0 CFG[0] = 0
CAP-XX Super-capacitors
AVX Super-capacitors
1206 Footprints

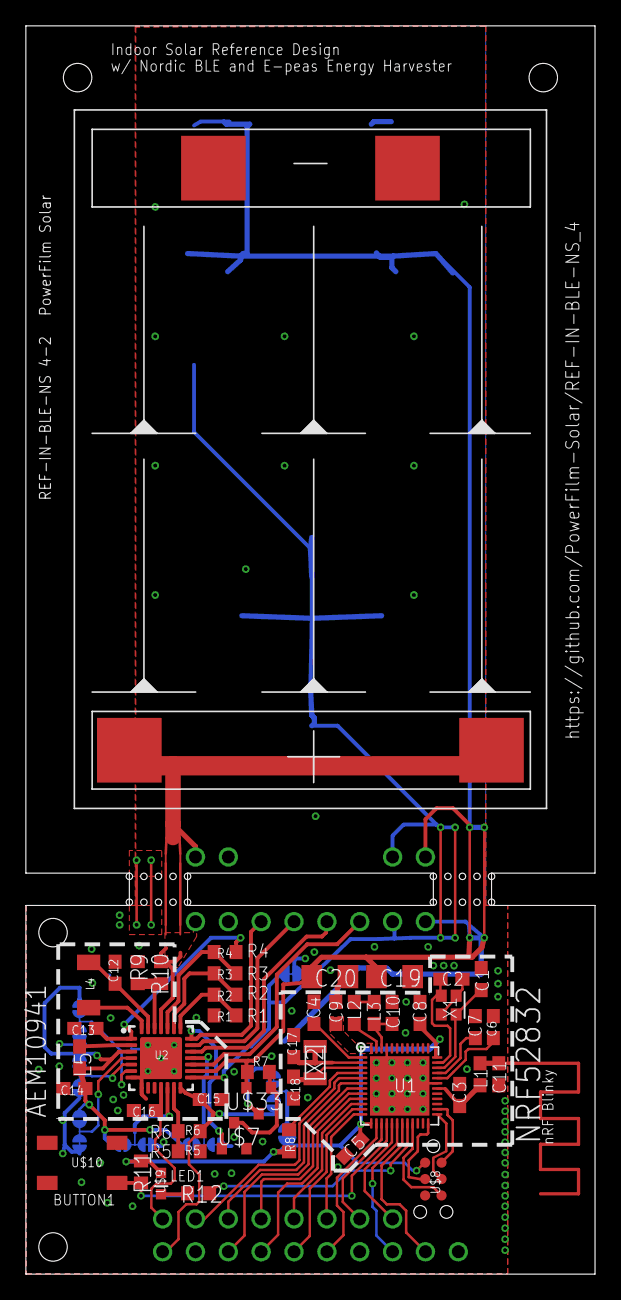
[picture p30: board REF-IN-BLE-NS 4-2 Rigid.brd from above]

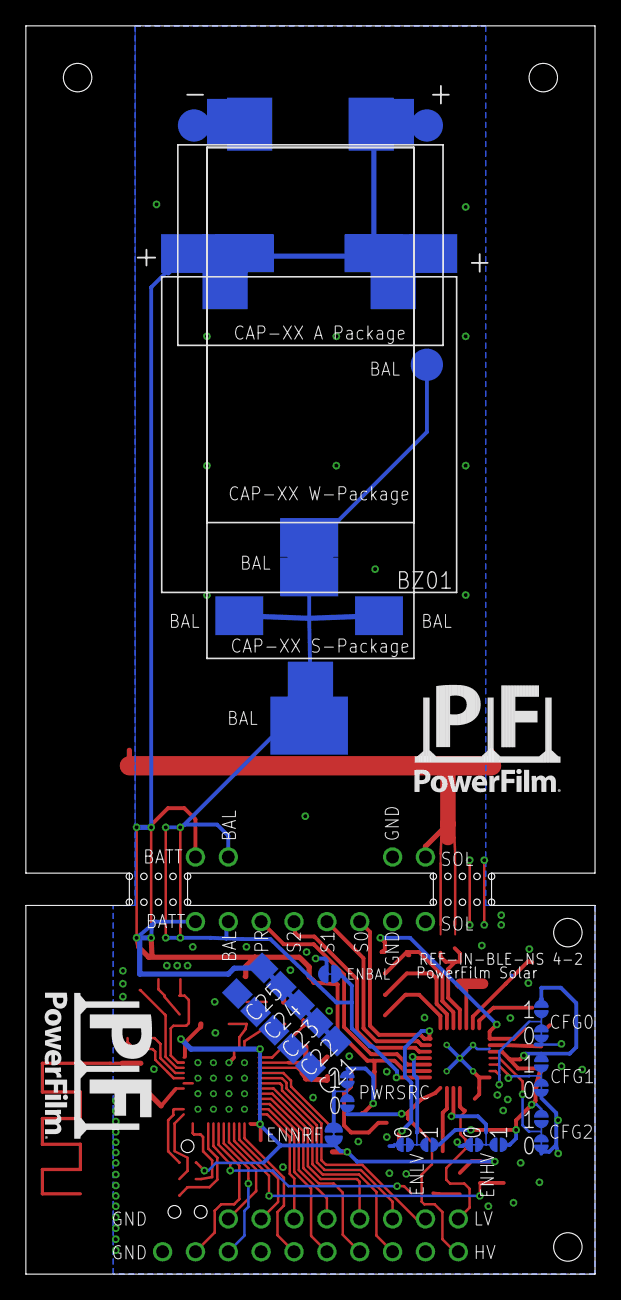
[picture p31: board REF-IN-BLE-NS 4-2 Rigid.brd from below]

Board: 4 copper layers, 44.0 x 96.5 mm, 82 parts (21 on the bottom side), 62 nets.
