PowerFilm-Solar/REF-IN-BLE-NS_4/(commit log)

2020-12-07 Added caps and prettied up
    Documentation is still needed, will add that as an issue
    [REF-IN-BLE-NS 4-0.brd, REF-IN-BLE-NS 4-0.sch]
2020-12-09 Fixed grounding and added labels
    [REF-IN-BLE-NS 4-0.brd, REF-IN-BLE-NS 4-0.sch]
2020-12-10 Modified top cream
    [REF-IN-BLE-NS 4-0.brd, REF-IN-BLE-NS 4-0.sch]
2020-12-10 Added MPNs to Device Technologies
    [REF-IN-BLE-NS 4-0.brd, REF-IN-BLE-NS 4-0.sch]
2020-12-11 Changed MPN for U$1
    [REF-IN-BLE-NS 4-0.brd, REF-IN-BLE-NS 4-0.sch]
2021-01-11 Second revision of board Added LDO bypass circuit to attempt to get a higher efficiency from the charge capacitors. Added a way to break away solar from the rest of the assembly. Moved pin connectors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
    [REF-IN-BLE-NS 4-0.brd, REF-IN-BLE-NS 4-0.sch]
2021-01-11 Small changes to layout
    [REF-IN-BLE-NS 4-0.brd]
2021-01-13 Update to v4-1
    Changed filenames to reflect version change
    fixes #1
    [REF-IN-BLE-NS 4-1.brd, REF-IN-BLE-NS 4-1.sch]
2021-03-03 v4-1 Final
    [REF-IN-BLE-NS 4-1.brd, REF-IN-BLE-NS 4-1.sch]
2021-03-03 Initial Revision 2 Commit
    Added flex board (currently unfinished)
    Added 10M resistor between BATT and VADC
    Rerouted and moved components to have cleaner ground plane near antenna
    Rigid Board:
    Added breakout for many pins on nRF52832
    [REF-IN-BLE-NS 4-2.GBL, REF-IN-BLE-NS 4-2.GBO, REF-IN-BLE-NS 4-2.GBP, REF-IN-BLE-NS 4-2.GBS, REF-IN-BLE-NS 4-2.GKO, REF-IN-BLE-NS 4-2.GTL, REF-IN-BLE-NS 4-2.GTO, REF-IN-BLE-NS 4-2.GTP]
2021-03-03 Converting to multiple folder scheme
    [REF-IN-BLE-NS 4-1.brd, REF-IN-BLE-NS 4-1.sch]
2021-03-03 Added pinout for rigid board
2021-04-27 Merged PCBs and examples into one repo
    [REF-IN-BLE-NS 4-2 Rigid.brd, REF-IN-BLE-NS 4-2 Rigid.sch, REF-IN-BLE-NS 4-2.brd, REF-IN-BLE-NS 4-2.sch]
2021-04-27 Deleted old files/folders
    [REF-IN-BLE-NS 4-2.GBL, REF-IN-BLE-NS 4-2.GBO, REF-IN-BLE-NS 4-2.GBP, REF-IN-BLE-NS 4-2.GBS, REF-IN-BLE-NS 4-2.GKO, REF-IN-BLE-NS 4-2.GTL, REF-IN-BLE-NS 4-2.GTO, REF-IN-BLE-NS 4-2.GTP]
2021-04-27 Added LDO bypass circuit block image
2021-05-20 Removed internal pullups, changed xtal caps 12pf
    [REF-IN-BLE-NS 4-2 Rigid.brd, REF-IN-BLE-NS 4-2 Rigid.sch, REF-IN-BLE-NS 4-2.brd, REF-IN-BLE-NS 4-2.sch]
2021-06-08 Added photos, modified boards.c
2021-08-06 Finalized rigid & flex and code
    [REF-IN-BLE-NS 4-2 Rigid.brd, REF-IN-BLE-NS 4-2 Rigid.sch, REF-IN-BLE-NS 4-2.brd, REF-IN-BLE-NS 4-2.sch]
2021-09-02 Added Mini board files
    [REF-BLE-MINI.brd, REF-BLE-MINI.sch, REF-BLE-MINI.xlsx]
2021-09-03 renamed layout and schematic files
